liuyiwei1317629/esp32/bridge/screen_assets/offline_320x240.jpg

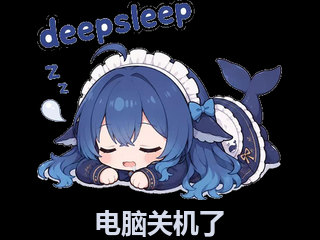
bridge/screen_assets/offline_320x240.jpg
