liuyiwei1317629/esp32/HANDOVER-G.md

# G 包交接单（ESP32-S3 硬件上机 / 录音回放）

> 用途：新对话接手的唯一上下文来源。只写结论与依据，不复述对话过程。
> 更新时间：2026-10-26 21:47
> 21:47 **定稿**：沙沙、响度一致性、破音三项全部收口。最终版 `snapshots/2026-10-26_final-v3/`（`TARGET_RMS=2700` / `GAIN_MAX=8.0`）。
> 本次更正两条大错：① 烧录口**不是 CDC，是 CH343**（对应板上 COM 口），旧记录「与 CDC 口同一路」作废；
> ② `compThr` 阈值参照系 bug 已修 —— 这才是历史上「增益乱跳」的真身，与地、与硬件都无关。
>
> **2026-10-27 补记（联网部分已过，本文其余内容仍有效）**：
> - 联网两模式已上机：TURN 多轮 `result=ok`（`first_pcm_ms` 2.2–4.2 s），TURN_STOP 播放中按 BOOT 打断 `stop_ms=20/18`、`result=aborted`。当前烧的是 `APP_MODE_TURN_STOP`。
> - 开机 6 声诊断音阶**已删除**（只留录音开始那声 60 ms「嘀」）：带音阶时 4 次录音全零，删掉后每次 `voice=1`——经验事实，机制未查清，不要写成结论。
> - 播放缓冲 1 s → 3 s（`PLAY_STREAM_BYTES_MAX=98304`，不够时自动降 2 s / 1 s）。长回复断续从中后段大面积补静音缩到只在开头约 1 秒；开口缺口已定位为 bridge 侧 TTS 启动生产赤字（2026-10-27），**不归硬件管**，固件无需再改。
> - 录音/放音的电气参数（`CLIP_TARGET_RMS=2700`、`CLIP_GAIN_MAX=8.0`、音量天花板 8000）**全部不变**。

---

## 0. 一句话现状

**录放链路已定稿可用**：沙沙解决、响度一致、无破音。最终参数 `CLIP_TARGET_RMS=2700` / `CLIP_GAIN_MAX=8.0`，
快照 `firmware/voice_terminal/snapshots/2026-10-26_final-v3/`。

| 交付要求 | 状态 | 关键事实 |
|---|---|---|
| 回放无沙沙 / 无毛刺 | ✅ 已解决 | 地路径长度是**唯一**主因。模块与板子同坞 + 板子换 25 cm 短线即干净（3.11、3.12-A） |
| 响度一致 | ✅ 已解决 | 根因是 `compThr` 参照系 bug，2026-10-26 21:15 已修（3.13） |
| 音量够 | ⚠️ **触到硬件天花板** | 功放数字峰值上限约 **8000**，超过即模拟削顶（破音）。想更响只能换 4Ω 喇叭或提高功放供电 |

**这条硬件的音量天花板已经摸到**：`play_peak ≈ 6600` 不是调出来的，是 MAX98357A（12 dB 增益）在 5 V 下的输出能力决定的。
再往上抬只会破音（4500 版 12745 实测「每个字开头结尾带咔」），**不要重复走这条路**。

**下一步不在音频**：音频收尾，进入联网部分（`APP_MODE != RECORD_ONLY`）。

---

## 1. 现在要做什么 / 最后交什么

**当前任务**：让 `C:\Users\DELL\voice-ai\firmware\voice_terminal` 在 ESP32-S3（ICS43434 数字麦 + MAX98357A 功放模块 + 小喇叭）上实现「按住说话 → 松手本地回放」，且回放**干净无毛刺、音量稳定、音量够用**。

**最终交付**：
1. 固化好的 `config.h` 参数集（不再逐次试错，能直接用的稳定版）
2. 一份硬件接线 + 烧录说明（含 bootloader patch 步骤，换 core 版本要重打）
3. 之后才进入联网部分（`APP_MODE != RECORD_ONLY` 的 Wi-Fi / HTTP 链路）

**当前工作模式**：2026-10-26 定稿时为 `APP_MODE_RECORD_ONLY`；2026-10-27 起改烧 `APP_MODE_TURN_STOP`（联网 + 打断），`MIC_DUMP = 0`（base64 导出已关）。

---

## 1.1 里程碑：录放链路定稿（2026-10-26 21:47）

三项硬要求全部收口。**当前 `final-v3` 是可交付版本**，可以直接进联网部分。

| 快照 | 参数 | 状态 |
|---|---|---|
| `snapshots/2026-10-26_clean-v1/` | `TARGET_RMS=1400` | 历史版，音质干净但音量偏小 |
| `snapshots/2026-10-26_clipfix-v2/` | `TARGET_RMS=4500` / `GAIN_MAX=12` | **有破音，勿用**（play_peak 12745 超过功放上限） |
| `snapshots/2026-10-26_final-v3/` | **`TARGET_RMS=2700` / `GAIN_MAX=8.0`** | ✅ **当前定稿** |

定稿实测（连录 5 次，其中 2 次因音量太小被固件主动丢弃）：
`play_peak = 4772 / 6170 / 6631`，`gmax = 6.05~6.46×`，最高只到功放上限的 83%。

**接法定稿（双线并行，已实测无沙沙）**：

| 线 | 插哪个口 | 承担 |
|---|---|---|
| 长线（有数据芯） | 板子的 **COM 口** | CH343 → COM5，烧录与日志 |
| 25 cm 短线（纯供电） | 板子的 **USB 口** | 承担音频回流，地路径短 |

两根线插同一个坞。**好处是不用为调试反复拔线**——之前"短线干净但没数据、长线有数据但地长"的死结由此解开。
（原理：两个口的 5V/GND 在板内是同一组铜箔，音频回流优先走阻抗更低的短线。）

---

## 2. 最新要求 / 已作废的旧要求

### 2.1 仍然有效的要求

| 要求 | 来源 | 当前状态（2026-10-26 21:47） |
|---|---|---|
| 回放不能有任何毛刺、发毛、沙沙声 | 用户连续 5 轮明确反馈 | ✅ **已达成**。地路径是唯一主因（3.11 / 3.12-A） |
| 同样距离、同样音量说话，几次回放响度要一致 | 用户：「前两次有可能一样，后两次可能不一样」 | ✅ **已达成**。根因是 `compThr` 参照系 bug（3.13），修复后波动 5.2 倍 → 1.06 倍 |
| 音量要够（能听清、不费劲），但不能用失真换 | 用户：15000 时「大小正好」但同时「毛刺」 | ⚠️ **部分达成**。不破音优先，实际音量受功放 8000 削顶约束（3.14）。注意：用户当年说「15000 正好」时同时有毛刺，那个判断本身可能不可靠 |
| 用户不会用万用表、不会拆 2P 母头，所有指导必须"插上/接上就行" | 用户明确表示 | 持续遵守 |
| 每次改动后必须让用户实测并回报三个数：`mic_raw` / `clip` / `play_peak` | 本包工作方式 | 持续遵守 |

### 2.2 已作废的要求（不要再按这些方向做）

| 作废内容 | 作废原因 |
|---|---|
| 「把回放峰值推到 15000 / 21334 换取音量」 | 实测该电平必然毛刺/破音，是削顶 |
| 「播放侧做逐块 AGC（最高 8×）补音量」 | 与录音侧归一化叠加两次，底噪被抬到满幅 |
| 「归一化基准用块峰值的 95 分位」 | 短句时 95% 的块是静音，估算失真（gain 掉到 0.57×）|
| 「降噪门压深到 0.22（-13 dB）」 | 产生音节级抖动；且后来证实不是毛刺主因 |
| 「存在感提升 +5 dB」→ 现为 +2 dB | +5 明显偏冲、刺耳 |
| 「I2S TX 用 MONO 槽位」 | MAX98357A 只认 32/48/64 BCLK-per-frame，单槽输出噪音 |
| 「用 `psramFound()` 判 PSRAM」 | Arduino 的 `spiramFailed` 标志会误报，必须用 `esp_psram_get_size()` |
| 「固定 6× 数字增益」 | 满幅方波触发功放过流保护 → 彻底静音 |

---

## 3. 已确认的事实（每条附依据）

### 3.1 硬件与工具链

| 事实 | 依据 |
|---|---|
| SoC：ESP32-S3 N16R8（16MB flash / 8MB OPI PSRAM） | esptool `flash_id` + `esp_psram_get_size()` 实测 |
| Flash 是 XMC，JEDEC `0x207018`，**不在 IDF 白名单内** | `bootloader_flash_xmc_startup` 反汇编 |
| 必须 patch 4 个 bootloader ELF，偏移 `0x3EF1`，`66caed` → `661aed`（`bnei a10,32` → `bnei a10,1`） | 已 patch 并验证可启动；**升级 esp32 core 后需重打**，原件备份在 `D:/arduino-cli/bootloader-backup/` |
| `FlashMode` 必须 `dio`（QIO 启动失败） | 编译/启动实测 |
| 烧录口 = **COM5 = CH343**（`USB\VID_1A86&PID_55D3`），对应板上的 **COM 口**；**不是 native CDC** | 2026-10-26 21:23 `Win32_PnPEntity` 实测设备名 `USB-Enhanced-SERIAL CH343 (COM5)` |
| 板上共两个 Type-C 口：**COM**（经 CH343 → UART0/GPIO43-44）与 **USB**（直连 SoC 原生 USB，GPIO19-20）。**两口的 5V/GND 在板内是同一组铜箔** | 同上实测 + 板面丝印（ESP32-S3 2025-V1.4） |
| ⚠️ 旧记录「烧录口与 CDC 口是同一路」**是错的**（2026-10-26 21:23 更正）。22:00 前查 VID_1A86 得 0，是因为当时插的是无数据线芯的纯充电线，CH343 未被枚举——**不是板子没有桥** | 两条记录对照 |
| 串口监视必须 `DtrEnable=false`，并手动拉 `RtsEnable` 触发复位；`arduino-cli monitor` 不会触发复位 | 反复试出来的 |

### 3.2 接线（用户提供的引脚分配，已按此跑通有声）

```
话筒 ICS43434 :  BCLK=GPIO4   WS/LRC=GPIO5   SD/DATA=GPIO6
功放 MAX98357A:  BCLK=GPIO15  WS/LRC=GPIO16  DIN=GPIO7
```

> ⚠️ **2026-10-26 15:01 更正（重要）**：此前这里写的「模块针序 VCC GND LRCLK BCLK DIN WS SCK SD」
> **是未经验证的推断，已作废**。用户明确说明：**模块只有一个 GND，没有可插杜邦线的 VCC / GND 针**。
> 模块供电只有那根**一体注塑、掰不开的自带 USB 线**（红=5V、黑=GND）。
> 也就是说：**「给模块 GND 针补一根杜邦线到板子 GND」这一步在物理上做不到**，不要再去指导用户这么做。
> 同理，别假设模块有可用焊盘或第二个接地点——这一点**仍未确认**，需要用户拍模块正反面照片才能定。

- 模块内部**没有共同时钟**（测过 7 组引脚，全 open）
- 喇叭未损坏（`tx_only_check` 探针能出声）
- **共地方式（重要，勿搞错）**：模块 GND 与板子 GND 之间**没有、且在现有硬件上也加不了直连线**。共地只能"借道"：
  ```
  模块 GND ─黑线→ 电脑 USB 口A 的 GND ─主板→ 电脑 USB 口B 的 GND → 板子 GND
  ```
  因此**两个 USB 口必须来自同一台电脑**，否则 I2S 失去公共参考（表现是噪音或无声）。
  > 这条「借道主板」的地不是等效的好地：功放的开关电流（几百 kHz、峰值可到 0.5 A）也走这一段，
  > 于是地电位随输出电流上下晃 —— 这与 3.9「噪声跟着输出电流走」的结论方向一致。
  > **现有硬件无法改善这条地**，能做的只有降电平或换模块（见 7）。

### 3.3 录音链路（已验证正常，不要再怀疑）

- 实测一次正常录音：语音从 448 ms 开始，频谱 **500–1000 Hz 占 49.6%**、250–500 Hz 占 25%
- 话筒原始峰值 `s16` 约 2600–4500（满幅 8%–14%），RMS 470–820
- `underruns=0`，`play_ms` 与 `record_ms` 基本一致
- 结论：**话筒、I2S RX、编码、增益链路全部正常**

### 3.4 用户声音的频段特征（决定了滤波器设计）

对导出的原始 PCM 做 FFT：

```
0-250 Hz  47.90%
250-500   44.67%
500-1000   2.26%
1000-2000  1.46%
最强峰：207 / 208 / 230-232 Hz
```

即 **92% 能量在 500 Hz 以下，最强峰在 210 Hz 附近**。小喇叭在这段需要最大电流和行程，是最容易失真的频段。

### 3.5 播放链路的关键约束（都是实测踩出来的）

| 约束 | 依据 |
|---|---|
| I2S TX 必须 **STEREO** 槽位（32 BCLK/frame），数据左右两槽写同一份 | 单槽（16 BCLK/frame）时功放输出纯噪音 |
| 播放期间必须 **`rxDisable()`**，播完再 `rxEnable()` | 两路 I2S 争用同源时钟，RX 开着时功放完全收不到有效帧（静音） |
| DMA：`TX_DMA_DESC=6` × `TX_DMA_FRAME=240` = 1440 帧 ≈ 90 ms 缓冲 | 当前配置，`underruns` 一直为 0 |
| 播放任务 `audio_tx` 优先级 4、钉在 core 1，高于 Arduino `loop` | 不会被串口打印抢占 |

### 3.6 电平阶梯实测（关键，但只有两个点可信）

用固件内置的 1 kHz 纯音阶梯（**不经话筒、不经任何滤波**）：

| 报告 | 结论 |
|---|---|
| 「第 3~4 声之后 1234567 就全都是噪音了」（4000→16000 七级） | 8000 起明显噪音 |
| 「第二声。有毛刺儿」（5000/6000/7000/7800 版，第二声 = 6000） | **6000 已有毛刺** |
| 4000 干净 | 干净区上界 ≥ 4000 |

**注意**：因为纯音也不干净，所以毛刺**不在录音链路、也不在数字滤波/压缩算法里**，一定在 I2S TX 之后（功放 / 供电 / 喇叭）。

> ⚠️ 本节的「8000 是上限」「6000 已有毛刺」**已被 3.9 修正**：那两轮测试时软限幅器的拐点分别是 7000 和 4200，用户听到的"噪音"大部分是限幅器削波，不是功放。真实上限远高于 8000。

### 3.9 决定性实验：噪声跟着输出电流走，不跟数据跳变走（2026-10-26，已确诊）

前面所有测试都混着两个变量，这一轮用 2 的幂做 2×2 对照 —— 2 的幂二进制只有一个 1，
所以无论幅度多大，DIN 每帧只跳变 1 次，可以把「输出电流」和「数据跳变」彻底分开：

| 段 | 直流值 | DIN 每帧跳变 | 输出幅度 | 用户听感 |
|---|---|---|---|---|
| F1 | 2048 (`0x0800`) | **1 次** | 6.25% | 有沙沙 |
| F2 | 8192 (`0x2000`) | **1 次** | 25%（电流 ×4） | **明显更吵** |
| F3 | 2000 (`0x07D0`) | **5 次** | 6.1%（跳变 ×5） | 不比 F1 吵 |
| F4 | 0 | 0 次 | 0 | 基线，很微小 |

**结论（这是目前最硬的一条）：**

- **F2 > F1** → 跳变次数相同、电流差 4 倍 → 噪声随**输出电流**上升
- **F3 ≈ F1** → 幅度几乎相同、跳变差 5 倍 → 噪声**与数据跳变无关**

所以噪声是**加性、随输出功率增长**的电源侧噪声（去耦不足或供电电流不足），
不是位误读、不是串扰、不是时钟抖动、不是数据传输出错。

同一轮的另外三条支持证据：

- 恒定直流（DIN 无跳变）**也有**沙沙 → 排除"数据传输错误"
- 采样率 16 kHz → 8 kHz（BCLK 512 kHz → 256 kHz）**一样脏** → 排除信号完整性与时钟相关问题
- 同配置连测两次结果**一致** → 排除接触不良这类随机故障

### 3.7 提示音尾音污染归一化（已修复）

每次录音的前 1–2 个 32 ms 块 RMS 高达 2018–2120，随后骤降到 200 左右 —— 那是按键提示音「嘀」的尾音被话筒拾取。
后果：归一化把尾音当最大峰值，5 次录音的增益在 **3.72× ~ 7.48×** 之间乱跳，表现为"有时响有时轻"。

已修：录音丢开头 5 帧（100 ms）+ 峰值统计跳过前 3 块 + 提示音电平降到 4000/60 ms + 回放开头 64 ms 淡入。

### 3.8 用户当前供电方式（拓扑已确认）

**历史拓扑（前三轮全部测试都是这个）——两个 USB 口都来自同一台电脑**：

- 板子：USB 线接电脑（同时提供 COM5 串口）
- 功放模块：**另一根独立 USB 线**（红=5V、黑=GND，外壳一体注塑、掰不开、不能拆）接电脑的另一个 USB 口

因此模块与板子之间**没有 GND 杜邦线**，共地靠电脑主板"借道"（详见 3.2）。

**拓扑至今未变（2026-10-26 14:12 用户明确确认）**：用户原话「没有用，供电都是电脑供的」。
所有测试（包括我让你试充电头的那几轮）实际都是**板子插一个 USB 口、模块插另一个 USB 口，两路都来自同一台电脑**。
两个充电头只是备选，**从未真正接到模块上跑过测试**。

> 「USB 口 500 mA 限流是瓶颈」：**未实测排除**，但推理上不成立 —— 见 4 节候选 B。

### 3.10 独立电源方案（**未执行** —— 用户已明确：供电都是电脑供的）

用户手上有两只 USB 充电头，但**都没有接入测试过**。参数记录如下，供真正执行这一步时用：

| 电源 | 参数 | 状态 |
|---|---|---|
| 亚力通 P168S（2016） | 输入 110–240V 200mA，输出 **5.0V ⎓ 1A Max** | 未使用 |
| J-120W 开关电源适配器 | 输入 220V 50Hz 0.8A，输出 **5V3A / 9V2A / 11V1.5A / 12V1.5A**（多档快充） | 未使用 |

> 若将来确实要用：模块自带那根 USB 线的外端直接插 `P168S` 的 USB-A 口即可（红=5V、黑=GND），
> 但**必须同时补一根杜邦线把模块 GND 接到板子 GND**，否则 I2S 回流绕经市电，只会更脏。
> 右侧那只多档快充头不要长期用——一旦握手异常升压到 9V/12V 会直接烧 MAX98357A。

> ⚠️ **2026-10-26 14:12 更正**：本节曾写成「已换两个充电头、结果一样脏，据此作废候选 B」。
> **该实验并未发生**，用户原话是「没有用，供电都是电脑供的」。该结论已撤回，候选 B 恢复为"低可信度、未实测排除"。

---

### 3.11 集线器（hub）对照：地回路坐实为主因（2026-10-26 20:40）

**唯一变量**：模块的 USB 线从「插电脑另一个 USB 口」改成「插同一个 USB 集线器」，板子也插在这个集线器上。
固件未改、`config.h` 未改，靠 `setup()` 里自带的 6 声阶梯判读
（800/900/1000/1100/1200/1300 Hz，电平 4000/6000/8000/12000/16000/20000，每次按 RST 自动跑一遍）。

| | 干净区上界 | 6000 那一级 | 用户用词 |
|---|---|---|---|
| 插坞前（历史记录） | **< 4000**（连 4000 也脏） | 有毛刺 | 「都有杂音」 |
| 插坞后 | **≥ 4000**（第 1 声干净） | 微弱沙沙 | 「明显变轻了」 |

**判读**：只缩短了地路径，没加任何电容、没改电流，噪声就下降一整档 → **候选 C（共地只能借道电脑主板）是主因**。

连带推论（三条都会影响选型，别再按旧结论走）：

- **候选 A（模块 VCC 去耦不足）不是主因**。插坞没有增加任何去耦，噪声依然大幅下降。7 针模块降级为"可选"，不是必须。
- **候选 B（供电电流不足）可以划掉了**。集线器上是多个口共享一个 USB 口（约 500 mA），比原来更紧，噪声反而更轻。
- **路 A（继续压低电平）作废**。当前 `CLIP_PEAK_CAP=4600` 正好落在插坞后的干净区内，不要再往下压。

**但地路径仍然不短**，当前这条回路是：
```
模块 GND ─30cm USB 线→ 坞 PCB ─板子那根 USB 线→ 板子 GND
```
板子那根 USB 线如果是 1 m，地还是长的。所以下一步不是换模块，是继续缩短这条路径（见 7 路 C）。

---

### 3.12 地问题已闭环 + 两个新发现（2026-10-26 21:00）

**A. 地回路彻底解决**

- 操作：模块与板子**同插一个 USB 集线器** + 板子换 **25 cm 短线**（USB-A → USB-C）
- 结果：用户原话「**没有沙沙声了**」——阶梯 6 声全部干净
- 结论：**地路径长度是唯一主因**，3.11 坐实。路 C 的 C-1 已完成，**C-2（USB 母座转端子）已无必要**，不必再买。

**B. ⚠️ `CLIP_PEAK_CAP` 是死参数（重要，会影响以后所有调参结论）**

- 全仓库只有 `audio_io.cpp:300` 那一行 `Serial.printf("... cap=%d", CLIP_PEAK_CAP)` 读它，**没有任何一处用它限制峰值**
- 真正的上限只来自 `softLimit()`（`LIMIT_KNEE`/`LIMIT_ROOM` = 32000/1，等于不限制）+ 32767 硬钳位
- 所以历史上若干轮「调峰值上限」改的都是这个死值，**「改了没变化」是正常现象，不是用户听错**
- **音量唯一真正的旋钮是 `CLIP_TARGET_RMS`**（块增益 = TARGET_RMS / 块RMS，上限 `CLIP_GAIN_MAX`=8×）

**C. 那根 25 cm 短线是纯充电线，没有数据线芯**

- 证据：`Win32_PnPEntity` 里查不到任何 USB 串口芯片（VID_303A / 1A86 / 10C4 / 0403 全部为 0），
  `COM3` / `COM4` 是蓝牙虚拟串口，`COM5` 已消失
- 表现：板子上电、能跑阶梯、能出声，**但串口不见，无法烧录**
- 处理：**烧录时换回有数据的线，烧完立刻换回短线听**（长线会让沙沙回来，但不影响烧录）
- 这根充电线以后接电池方案时正好用（电池场景只需供电，不需要数据）

---

### 3.13 `compThr` 阈值参照系 bug —— "增益乱跳"的真身（2026-10-26 21:15 修复）

**症状**：同一句话连录，回放响度忽大忽小。用户描述"前两次一样、后两次不一样"，
历史记录里出现过增益在 3.72×~7.48× 之间乱跳。**此前一直误判为地噪声的副作用，实际与硬件无关。**

**实测数据（修复前，连录 8 次，同一句话同一距离）**：

| 输入 RMS | 输入峰值 | play_peak | 实际倍数 |
|---|---|---|---|
| 493 | 1540 | 6202 | 4.0× |
| 515 | 1415 | 4396 | 3.1× |
| 506 | 1187 | 3867 | 3.3× |
| 497 | 1332 | 3990 | 3.0× |
| 547 | 1218 | 2154 | 1.8× |
| 505 | 1534 | 4865 | 3.2× |
| 502 | **1196** | **1196** | **1.0×** |
| 476 | 1298 | 3737 | 2.9× |

最后那行是铁证：`play_peak` 与输入 `peak` 一个 LSB 不差，压缩**完全没有启动**。

**根因**（`audio_io.cpp` 第 5a 步，修复前）：

```cpp
const float compThr = floor_rms * CLIP_COMP_THR;  // floor_rms 来自【滤波前】块 RMS 的 20 分位
float r = postRms[k];                             // postRms 是【滤波+门控后】的能量
```

`postRms` 经过两级 4 阶高通（250 / 300 Hz，正好砍在语音主能量上）再乘门控 0.70，
实际只剩滤波前的 1/3~1/4。用滤波前的底噪 ×2.5 去卡滤波后的能量，**门槛虚高约 10 dB**，
大量真实语音块被判为静音 → `want=1.0` → 整段不压缩。

于是增益在「1.0×（全段不压）」和「4×（块块过线）」之间二值跳变，取决于那一刻说话多响。
这也解释了为什么"凑近说反而更弱"——输入变轻，整段掉进不压缩区。

**修法**：底噪改用 `postRms` 自己的 20 分位（`floor_post`），与被比较量同尺度；
日志探针从 `g0/gN`（首末块，恒为 1.00×，毫无信息量）改为 `floor=滤波前/滤波后`、`thr`、`g=min~max`。

**修复后实测（`TARGET_RMS=3000`，连录 3 次）**：`play_peak = 7452 / 7659 / 7879`，
**波动从 5.2 倍降到 1.06 倍**；输入 RMS 533/558/581 本身差 9%，输出比输入还稳。

**教训**：`g0/gN` 这种"首末块"探针会伪装成"没压缩"。排查压缩问题必须看**全段最大增益**。

---

### 3.14 功放削顶上限约 8000（2026-10-26 21:34 实测坐实）

`CLIP_TARGET_RMS=4500`（`GAIN_MAX=12`）时实测 `play_peak=12745`，用户听到「每个字开头结尾带咔/破音」。
退到 3000（`GAIN_MAX=8`）后连录 4 次 `play_peak = 8618 / 6485 / 7853 / 7221`，
用户确认「8618 那次破音、其余三次正常」——**上界坐实在 8000 附近**。

- 削波发生在 **MAX98357A 的模拟侧**（12 dB 增益把数字满幅推到电源轨），不是数字侧
  （12745 远低于 32767，也远低于 `softLimit` 拐点 32000）
- 数字侧完全干净，**不要试图靠调 `CLIP_PEAK_CAP`（死参数）解决**
- **不要调低 `LIMIT_KNEE`**：软限幅是逐样本非线性压缩，会引入谐波（听感"糊"），
  为偶发峰值牺牲整体音质不划算。正解是压低整体目标，让峰值天然落进安全区
- 想真正更响：换 **4Ω 3W 喇叭**（同一电压下比 8Ω 响约一倍），或提高功放供电。
  两者都属硬件改动，且会改变声学负载，噪声与破音需重测

---

## 4. 未验证的推测（不可当事实用）

| 推测 | 可信度 | 如何验证 |
|---|---|---|
| 噪声来自**电源侧**（3.9 已确诊：随输出电流上升，与数据跳变、时钟频率无关）。细分到哪一环，尚未区分 | 方向：已确诊；细分：未知 | 见下三行 |
| └ 候选 A：模块 **VCC 去耦不足**（成品模块电源脚只有一颗 10 µF，缺 100 µF 电解 + 0.1 µF 陶瓷） | **高**（3.10 排除候选 B 后升为首选） | 在模块 VCC–GND 之间就近并 100 µF 电解 + 0.1 µF 陶瓷，噪声明显下降即证实 |
| └ 候选 B：**供电电流不足**（电脑 USB 口约 500 mA，功放峰值需 1 A 以上） | **低**：未实测排除，但 F1 段只有 6.25% 电平（DC 2048）、电流仅几十 mA 就已"有沙沙"，任何 USB 口都供得起 | 接 3A 独立电源实测才能排除，做法见 3.10 |
| └ 候选 C：**共地只能借道电脑主板**——模块唯一的地是 USB 线黑线，没有可插杜邦的 GND 针 | **高**，但**现有硬件无法验证也无法修复** | 只能换带 VCC/GND 杜邦针的 7 针模块（见 7 路 B） |
| 小喇叭机械擦圈 / BTL 输出在大量程下非线性（也能解释"随电流变脏"） | 低（静音时基线很微小，说明功放静态干净） | 换一只喇叭对比；或同电平下换频率看脏度是否随行程变化 |
| MAX98357A 实际增益 ≈ 4.1×（12 dB），不是模块常说的 9 dB | 中（由"8000 开始削顶"反推，32767/8000≈4.1） | 查模块 GAIN/SD 脚电阻分压配置，或用示波器看输出摆幅 |
| 喇叭阻抗是 8Ω | 低（**完全未确认**） | 看喇叭背面丝印，或量直流电阻（用户无万用表，暂不可行） |

---

## 5. 试过不行的路（别重复）

| 试法 | 结果 | 原因 |
|---|---|---|
| 固定数字增益 6× | 播到 `play_peak=32768` 后**彻底静音** | 满幅方波触发功放过流保护 |
| 播放侧逐块 AGC（最高 8×） | 「能听清但有巨大噪音」 | 与录音侧归一化叠加两次，底噪被抬到接近满幅 |
| 归一到 21334 | 「破音」 | 远超安全电平 |
| 归一到 15000 + 95 分位基准 | 「毛刺」+ 增益 0.57× 自我衰减 | 分位数估算错误 + 电平过高 |
| 降噪门 0.22 / −13 dB | 「毛刺」 | 音节级增益抖动；但门改浅后毛刺仍在，**证明不是主因** |
| 存在感 +5 dB | 「刺」 | 过冲 |
| 把峰值一路推到 16000 换响度 | 「全都是噪音」 | 方向本身错了，音量不能靠抬峰值 |
| 每次录音前 base64 导出 PCM（18 秒） | 用户以为设备卡死 | 应改用其他方式取证 |
| 换采样率 16k→8k（BCLK 512k→256k）、电平逐级 4000→20000 | 一样脏 | 见 3.9：与时钟频率、数据跳变无关 |

---

## 6. 冲突与待澄清（不要自行取一个当事实）

1. **B 声（16000）到底干不干净**：用户先说「听到嘀了，回放也有声」「干净」，后说「B 也有呃，杂音」。→ 按后者（有杂音）处理。
2. **噪声起始电平**：先说「3~4 声之后全噪音」（→8000），后说「第二声有毛刺」（→6000）。→ 取更严格的 6000。
3. **安全上限数值**：早期文档推算 11600（按 9 dB 增益），与实测「8000 就削顶」冲突。→ **以实测为准**，11600 作废。
4. **"15000 时声音大小正好"**：该次同时有毛刺。→ 不能作为目标音量，只能说明用户期望的响度参考值在"听起来有 15000 那么响"的量级。
5. **毛刺是否与频率有关**：用户报告扫频「有断续/杂音」，但没说清在低频还是高频段。→ 未定，不要假设。

### 6.1 我（上一轮 agent）编造过、已被用户当场否掉的硬件事实

**下一个对话接手时，下面这些一律不许当成已知条件：**

| 我编的说法 | 实际（用户指出） |
|---|---|
| 「模块 GND 要接板子 GND」这一步 | 用户：「没有供地线。你这里不对」 |
| 「SD 引脚就是功放 GAIN 脚」 | 混淆了话筒 ICS43434 的 SD 与 MAX98357A 的 SD_MODE，整条推论作废 |
| 「模块针序 VCC GND LRCLK BCLK DIN WS SCK SD」 | 用户：「一个一个，只有一个 GND」——**模块没有可插杜邦的 VCC/GND 针** |
| 「已换两个充电头供电、结果一样脏」 | 用户：「没有用，供电都是电脑供的」——该实验从未发生 |

**结论**：凡是涉及「模块上有什么针 / 焊盘 / 接地点」的陈述，**在拿到模块照片前一律不许写**。
现在唯一确定的物理事实只有：模块自带一根一体注塑的 USB 线（红=5V、黑=GND），只有一个 GND。

---

## 7. 下一步 + 合格标准

> ⚠️ 「加一根 GND 杜邦线」这条**已作废**（2026-10-26 15:01）：模块只有一个 GND，且是 USB 线里的黑线，
> 没有可插杜邦的 GND 针。这一步物理上做不到。下面两条是现在真正可走的路。

### 路 C（当前主路，免费 + ¥3）：继续缩短地路径

依据：3.11 已证明缩短地路径有效，且效果显著。所以继续压这条路径，而不是换模块。

**C-1（免费，今天就能做）**：把**板子那根 USB 线换成最短的**（30 cm 级）。
现在的地回路是「模块 30cm 线 → 坞 → 板子那根 USB 线 → 板子」，板子那根线如果是 1 m，地就是长的。
换完再按一次 RST，听第 2 声（6000）的沙沙有没有退掉。

**C-2（¥3）**：买 **USB 母座转接线端子**（搜「USB母座转接线端子」「USB母头转接板 端子」）。
模块自带的 USB 线插进母口，端子上的 +5V / GND 用两根杜邦线接到板子的 5V 针和 GND 针。
- 不用焊、不用剪线、不用万用表，拧螺丝就行
- 效果：模块彻底脱离电脑，地路径从「30cm + 坞 + 板子的线」缩到「30cm + 5cm」
- 注意：模块的电流从此走板子的 USB 口（500 mA 上限）。如果板子反复重启 = 电流顶到了，退回集线器方案。

**合格标准**：阶梯第 2 声（6000）的沙沙消失，或真实录音回放（当前 `CLIP_PEAK_CAP=4600`，已落在干净区内）听着干净。

**C 路失败再考虑路 B**：如果地路径压到最短、真实录音回放仍脏，剩下的才是模块去耦（候选 A），那时才买 7 针模块。

### 路 A（❌ 已作废，2026-10-26 20:40）：把电平再压低

> 作废原因：3.11 证明噪声主要不是电平问题，而是地路径问题。且当前 `CLIP_PEAK_CAP=4600`
> 已落在插坞后的干净区内，再往下压只是白丢音量。**不要再调这两个参数。**
> 以下内容仅存档，不要执行。

**注意**：最新一轮 6 档阶梯（4000 / 6000 / 8000 / 12000 / 16000 / 20000）用户报的是「都有杂音」——
**连 4000 也脏**，所以"4000 是干净区"这个旧结论在当前配置（限幅器已旁路）下**不成立**，不要再引用。

仍然值得一试的理由：沙沙的响度确实跟着电平走（3.9 已证），往下压到 2000~3000 时沙沙会退到"底噪级"，至少不刺耳。

- 操作：`CLIP_PEAK_CAP` 4600 → **3000**，`CLIP_TARGET_RMS` 1400 → **900**，编译烧录，录 3 次话
- 合格标准：3 次回放里沙沙**不刺耳、不盖住人声**（不要求完全消失）
- 若不通过 → 路 A 这条也不成立，只能走路 B
- 代价：明显小声。这是拿音量换安静的临时方案

### 路 B（根治，需要买一块模块）：换标准 7 针 MAX98357A 模块

现在这块是**自带 USB 线的成品音箱板**：供电只能走 USB，没有 VCC/GND 杜邦针，
所以永远只能"借道电脑主板"共地 —— 这个拓扑下的地噪声**没法修**，也不排除模块本身去耦就不够。

- 要买的是：**7 针杜邦排针的 MAX98357A 模块**（VIN / GND / LRC / BCLK / DIN / GAIN / SD），
  电源脚最好带 **≥100 µF 电解 + 0.1 µF 陶瓷**去耦
- 换上去之后才第一次真正做到「模块 GND ── 短线 ── 板子 GND」的共地，同时也解决了 VCC 去耦
- 到货后用 3.9 的 2×2 对照复测：F1 / F2 的脏度差应该消失
- 合格标准：2×2 里 F2 不比 F1 明显更吵；录音回放在 12000 以上还能听清

### 建议顺序

**路 C 是主路**（2026-10-26 20:40 改）：地回路已被 3.11 证明是主因，所以按"继续缩短地路径"走——C-1 免费、C-2 只花 ¥3，都比等快递快。
**路 B 降级为备选**：只有当 C 路压到最短、真实录音回放仍然脏时，才说明模块去耦不足，那时再买 7 针模块。
**路 A 作废**：别在电平参数上反复调（历史上已经为它调了 10+ 轮）。

### 唯一待用户确认的硬件信息

**模块正反面照片**。现有描述里「模块有 VCC/GND 杜邦针」是我推断出来的，用户已指出不成立；
在拿到照片前，**不要再对模块引脚做任何假设**（不要再说"接 GND 针 / VCC 针 / 焊盘"）。

---

## 8. 操作速查（接手直接用）

**源码目录**：`C:\Users\DELL\voice-ai\firmware\voice_terminal\`
（`voice_terminal.ino` / `audio_io.cpp` / `audio_io.h` / `config.h`）

**编译**
```
cd C:/Users/DELL/voice-ai/firmware && \
D:/arduino-cli/arduino-cli.exe --config-file D:/arduino-cli/arduino-cli.yaml compile \
  --fqbn "esp32:esp32:esp32s3:FlashMode=dio,FlashSize=16M,PSRAM=opi,PartitionScheme=default,CDCOnBoot=default" \
  --output-dir D:/arduino-build/g-record voice_terminal
```

**烧录**
```
同上，把 compile 换成：upload -p COM5 --input-dir D:/arduino-build/g-record
```

**串口抓取**（PowerShell，必须 `DtrEnable=$false`，否则不复位）
```powershell
$sp = New-Object System.IO.Ports.SerialPort("COM5",115200,"None",8,"One")
$sp.DtrEnable = $false; $sp.RtsEnable = $false; $sp.Open()
# 循环读 BytesToRead 写文件；抓取期间串口被占用，烧录前必须先停掉
```
日志落在 `C:\Users\DELL\WorkBuddy\2026-10-26-06-53-55\.tmp\serial_captureNN.txt`

**抓取与烧录互斥**：串口被占用时 `upload` 会报 `Could not open COM5`，必须先停抓取进程。

**当前关键参数（config.h）**

| 参数 | 值 | 含义 |
|---|---|---|
| `CLIP_TARGET_RMS` | **2700**（2026-10-26 21:42 定稿） | **音量唯一真正的旋钮**：块增益 = 本值 / 块RMS。上限受功放 8000 削顶约束（3.14） |
| `CLIP_GAIN_MAX` | **8.0**（2026-10-26 定稿） | 块增益上限。曾设 12，导致 gmax 到 9.4×、峰值 12745 破音，已回退 |
| `CLIP_PEAK_CAP` | 4600 | ⚠️ **死参数，不生效**，只被串口日志打印。调它没有任何作用，见 3.12-B |
| `LIMIT_KNEE` / `LIMIT_ROOM` | **32000 / 1** | 软限幅**已旁路**（拐点抬到顶、压缩区间压到 1），只做防溢出钳位——毛刺主因曾是这个限幅器 |
| `PLAY_FIXED_GAIN_Q8` | 256 | 播放侧固定增益 1.0×（不再做二次放大） |
| `CLIP_HP_HZ` / `CLIP_HP2_HZ` | 250 / 300 | 两级高通（4 阶，砍 200–300 Hz） |
| `CLIP_LP_HZ` | 3800 | 低通 |
| `CLIP_PRESENCE_DB` | +2.0 @ 2.2 kHz | 存在感提升 |
| `CLIP_GATE_FLOOR` | 0.70 | 静音块只压 −3 dB |
| `CLIP_COMP_THR` | 2.5× **滤波后**底噪 | 低于此的块不参与压缩。**注意：参照系必须是 `postRms` 自己的分位**，用滤波前的 `floor_rms` 会虚高 10 dB（3.13 的 bug）|
| `CLIP_MIN_PEAK` | 500 | 滤波后峰值低于此则整段丢弃不播。**说话太轻/太远会完全没声音**，当前已知副作用 |

**信号处理顺序**（`clipEnhance()`，全部在录音完成后一次性做）
```
去直流 → 高通250 → 高通300 → 峰值EQ 2.2k → 低通3800
→ 块RMS(32ms) → 底噪取20分位 → 浅门控(±2块平滑)
→ 块级压缩(快攻慢放+双边平滑) → 块内线性插值 → 开头64ms淡入 + 软限幅
```

---

## 9. 与用户沟通的注意事项

- 回复要短、要有具体数字，用户习惯用 3~10 个字回复（「有」「偏小」「毛刺」）
- 每轮只改一件事，别一次改三处（用户无法分辨是哪个改动起的作用）
- 不要说"再试一次"就完事，要说清这次改了什么、为什么、看到什么数就判定成/不成
- 用户已经测了 10+ 轮，**不要再做无依据的参数试探**，每次改动必须有数据支撑
