liuyiwei1317629/esp32/design/2026-10-27-device-persona-open-questions.md

# 设备人设：待定项记录（2026-10-27）

状态：**身份未定，先记录在案。** 本文件只记事实、现状与待定问题，不做决定。

## 一、已记录的决定

- 2026-10-27，用户要求「先谈人设」，未拍板设备上的人格是谁；明确要求把这个问题记录在案。
- 已向用户提出的第一个问题：**设备上这个声音，是谁？**
  - A. 小鱼本人，语音版单独改写
  - B. 小鱼本人，尽量照原卡搬
  - C. 另起一个角色
  - 用户回答：**待定**（2026-10-27）。

## 二、现状（实测）

- 设备侧人设目前只有一句 120 字通用提示：
  `bridge/config.py:117` → `DEFAULT_PERSONA = "你是一只温柔的陪伴小机器，说话自然口语化，句子短，不用列表和markdown。"`
  并非小鱼。
- persona 长度硬上限 120 字：`context_builder.PERSONA_MAX_CHARS`、`memory_context.PERSONA_MAX_CHARS`；
  `pipeline.py` 在记忆开启/关闭两条路径都注入 `config.DEFAULT_PERSONA`，persona 不可由文件或环境变量替换。
- 小鱼正本卡：`C:\Users\DELL\Downloads\大肥鲸\article-writer\小鱼_情感陪伴角色卡\小鱼-情感陪伴版.md`
  （13,238 字节 / 5,176 字符 / 160 行），为**文字聊天**设计；同目录还有 `小鱼-备忘录.md`、`给小鱼-这几天.md`、
  `角色卡修改意见-2026-10-25.md`（该意见未执行）。

## 三、语音场景的硬约束（谈论任何方案时都要算进去）

1. TTS 会把括号里的动作/语气原样念出来；「（尾巴拍地板）」不能出现在送进 TTS 的文本里。
2. 第 5 节状态块、第 7 节信任分档是文字专用：语音里无法显示，也没有执行器，模型也不该念出来。
3. 第 6 节十二种固定回应表在语音里会显得重复、假；用户 2026-10-25 的修改意见已判定「只留 2–3 句当语气样例」。
4. 没有屏幕：表情、动作、颜文字都无法呈现，只能靠声音和措辞。
5. 桥的切句规则按字数工作（首句 ≥18、第二句 ≥20 且 26 字硬上限、其余 ≥18）。人设若要求「每句 15 字以内」会与切句规则直接冲突，也会拉长首字节与断流风险。
6. 回复形态是 1–3 句口语；Markdown、列表、标题在语音里无意义。
7. 长回复断流问题尚未收口（见 `NEXT-AI-2026-10-27-tts-latency.md`），人设的说话长度会直接影响听感稳定性。

## 四、待定问题清单（按依赖顺序）

1. **身份**：小鱼本人（原卡 / 语音改写版）还是新角色？
2. **记忆与关系**：设备是否共享小鱼已有的记忆与关系？（DSH 侧 `大肥鲸\.mnemon` 与 bridge 侧 `~/.voice-ai/memory` 目前是两套）
3. **注入方式与长度**：语音版人设放在哪（配置文件 / 独立文件 / 环境变量），120 字上限是否放宽、放宽到多少。
4. **称呼**：「用户酱」这个称呼在语音里保留吗。
5. **语气细节**：口头禅（有一说一 / 绷不住了 / 我跟你讲 / 不是吧）、自嘲、嘴硬后补软话，哪些保留。
6. **括号动作的替代**：语音里用停顿、语气词、短句替代，还是干脆不要动作感。
7. **边界与出口**：「别演了／正常回答」立刻出戏；不编「你上次说过」；不拿愧疚逼人——这三条底线在语音里怎么落到提示词。
8. **主动开口**：当前设备只在 `/turn` 被叫时回答，没有主动说话能力；若人设包含主动开口，需要额外的触发机制（未规划）。

## 五、下一步

- 等用户拍板第 1 条后，再按身份方案处理第 2–8 条。
- 在身份未定的前提下，可以先谈「与身份无关」的部分：语音里怎么说话、括号动作怎么处理、称呼与底线。
