liuyiwei1317629/esp32/项目总结.md

# 小鱼语音项目 · 合并总结（截至 2026-10-28）

> 这份文件把以前散在各个 MD 里的**总结类内容**合并成一份，按主题去重、按时间补最新结论。
> 原文都还在，一个字没删；本文件只是把它们读成一份。
> 不含密钥、token、完整对话原文。

## 0. 合并了哪些、没合并哪些

| 处理 | 文件 | 说明 |
|---|---|---|
| 已并入 | `README.md`（根） | 选型、实测数字 |
| 已并入 | `RUNBOOK.md` | 环境、启动、关闭、打包 |
| 已并入 | `bridge/工程日志-2026-10-20.md` | 10-20 工程的经过与结论 |
| 已并入 | `bridge/工程日志-2026-10-28.md` | 记忆诊断与对接待办 |
| 已取要点 | `firmware/README.md` | 硬件、三模式、编译账 |
| 已取要点 | `bridge/README.md` | 接口、大脑路由、实测 |
| **未并入（交接单）** | `HANDOFF.md`、`HANDOVER-G.md`、`NEXT-AI.md`、`NEXT-AI-2026-10-27-tts-latency.md`、`handoff/B·C·F·G` | 按你的要求，交接单不用 |
| 未并入（设计文档） | `design/*.md` | 设计过程稿，不是总结 |

---

## 1. 这是什么

一台 ESP32-S3 语音终端 + 一台 PC 的本地语音陪伴链路。

```
ESP32-S3（麦 ICS43434 / 功放 MAX98357A / ST7789 屏）
   │ 录音 16k 单声道
   ▼
PC bridge :8080
   ├─ ASR   SenseVoice-Small（本机 GPU，约 0.5 GB）
   ├─ LLM   brains.toml 里的 profile → DeepSeek 云 / Ollama 本地
   └─ TTS   肥鱼(WSL) → CosyVoice(Windows) → edge 在线兜底
   │ 16k PCM 流（chunked）
   ▼
设备播放
```

- 设备只做「录 + 放」，理解、生成、合成全在 PC。
- 云端是唯一的人格与长期记忆大脑；本地模型只是功能插件。
- 调试台：`http://127.0.0.1:8080/console`（发文字/录音、看耗时、切大脑、改记忆、一键关闭）。

---

## 2. 现在的状态（2026-10-28）

| 线 | 状态 |
|---|---|
| 声线 | **肥鱼 cute（F6）**为主，链 `feiyu → cosyvoice → edge(晓萱)`；真机在用 |
| 分句 | 26 字硬上限改为「回退到最后一个断点」，最后一句不再消失；真机复验通过 |
| 播放缓冲 | 3 s 缓冲修好长回复断续（`1a14b2a`），**不回退** |
| 记忆 | 五层阶段 1–5 完成、真实目录已启用；10-28 补「每轮一条 event」，**未提交** |
| 屏幕 | 固件 + 推流代码完成并提交（`0ebd1e2` / `ffa1ad1`），**硬件未到货、未上机** |
| 唱歌 | 点播原唱 + 歌单进提示 + 页面音量（30/50/70/100）已实测；10-28 加「歌曲」面板（上传加歌 / 删歌，自动转 16 kHz），固件零改动 |
| 情绪 | 10-28 加本地关键词判断（`bridge/emotion.py`），开口时挑 6 段已有动画之一；**不改提示词、不调模型**，真机未验 |
| 人设 | 10-28 调试台「人设」面板：改 `~/.voice-ai/persona.txt`，上限 **120 字**（与记忆链路同一上限），空着保存=恢复默认，**下一轮生效、不用重启**；默认人设不变 |
| 本地大脑 | Ollama `qwen3.5:2b-q4_K_M`，默认关，断网兜底 |
| 计费 | 调试台顶栏「花费」：今日/本月/累计 + 按大脑拆分，数据来自 `usage.jsonl`；**只读，不设上限** |
| 唤醒词 | **2026-10-28 决定放弃**；只用板载 BOOT 键 |
| 测试 | 43 个 unittest 模块 / **594 例**通过，另有 3 个脚本自检 30 项；每个文件单独进程跑 |
| 推送 | GitHub 仍被墙（`github.com:443` 超时，`ssh.github.com:443` 通但无 key） |

---

## 3. 声线（当前主线）

**FeiyuVoice-CosyVoice3**（Fun-CosyVoice3-0.5B-2512 的小鱼微调，社区叫「肥鱼」）。

- 声线：**cute（F6，`feiyu_cute_F6_0040.pt` + `cute_N01.wav`）**；gentle 试听未选。
- 引擎顺序 `feiyu → cosyvoice → edge`；肥鱼占 3.4–3.6 GB 显存，所以**不与 CosyVoice 同时加载**（`engine.cosyvoice.loading` 恒 False，是设计不是故障）。
- 运行在 WSL2 Ubuntu 24.04；venv `/root/.local/share/feiyu-voice/venv311`；模型 7.0 GB 在 ext4 `/root/feiyu-voice/model`（放 `/mnt/d` 会被 9p I/O 拖到 250 s 加载）。
- 实测：cute RTF **0.66–0.80**（稳态 ≈0.73），gentle 0.83–1.25；加载 90–170 s，启动到 `feiyu.ready` **约 195 s**。
- 参考音 `cute_N01.wav` 是**合成音**（CosyVoice3 → 导出 → Feiyu RVC A60），不是真人录音。
- 首句延迟：已用 `add_zero_shot_spk` 把参考音频特征改成启动时算一次 → 每轮首句 TTS 2.5 s → **0.6 s**；`/api/text` 首句出声 **5.72 s**。
- 剩余延迟大头 = 句长 × RTF（25 字 ≈ 7 s 音频 → 5.3 s 合成），不再优化。
- 运维：`start-console.cmd` 启动时会清掉 WSL 里遗留的 `worker_feiyu.py`；正常关闭（调试台「关闭」/`/shutdown`）会连带 `pkill`；`tts.stop()` 已移入 `finally`，异常退出也收尾（`a884119`）。

> 历史：10-20 时「说」是 CosyVoice-300M-SFT，RTF 0.96–1.22、流式首包 2.46 s（fp32）。10-28 起主线换成肥鱼，CosyVoice 退为第二档。

---

## 4. 设备端

### 4.1 硬件与接线

- 板子：ESP32-S3（N16R8 类），两路独立 I2S：麦 ICS43434、功放 MAX98357A。
- 屏幕（10-28 加，未上机）：2.4 寸 **ST7789，8 针无 MISO**；**电源两针各接一处，不用一分二**。
- 供电：两根 USB（供电 + 串口）同机共地；不要用 9V/12V 多档充电头。
- 烧录口是 **CH343**（板上 COM 口），不是 CDC。`arduino-cli` 在 D 盘，必须带 `--config-file`，端口多为 COM5。

### 4.2 三种模式（都已上机验证）

| 模式 | 状态 |
|---|---|
| RECORD_ONLY | 2026-10-26 定稿 |
| TURN | 2026-10-27 跑通 |
| TURN_STOP | 2026-10-27 跑通（播报中按 BOOT 打断） |

操作：IDLE 按住 BOOT 录音，松开发送；静音 1.2 s 自动结束；最长 15 s；短于 0.3 s 丢弃；首字节那 2–4 s 内按键不响应。

### 4.3 音频定稿（不要动）

- `TARGET_RMS=2700` / `GAIN_MAX=8.0`，2026-10-26 `snapshots/2026-10-26_final-v3/` 定稿。
- 历史大错已修：① 烧录口不是 CDC 是 CH343；② `compThr` 阈值参照系 bug 才是「增益乱跳」的真身。
- 底噪/杂音的唯一主因是地线，**不要靠改音频参数解决**。
- 26 字是句子硬上限；到上限时回退到最后一个断点，不再按字数生切。

### 4.4 屏幕（代码完成、未上机）

- 固件 + bridge MJPEG 推流都写完并提交（`0ebd1e2` / `ffa1ad1`），含屏后 **flash 84%**，528 例测试通过。
- 推流需要 WSL 里的 ffmpeg；Windows 侧没有 ffmpeg。
- 上机验收清单在 `design/2026-10-28-screen-stream-plan.md` §9，等硬件到货。

---

## 5. PC 端：大脑与记忆

### 5.1 大脑路由

- profile 在 `~/.voice-ai/brains.toml`；DeepSeek 云端为主，Ollama 本地兜底（默认关）。
- 本地大脑实测：热身后首字 ≈1.3 s、首段音频 ≈8 s（大头是肥鱼合成），适合兜底不适合日常。
- `reasoning_effort = "none"` 是关思考的唯一有效写法（`think=false` 无效）。
- 用量账本 `~/.voice-ai/usage.jsonl`；密钥只在 `~/.deepseek/`，不进工作区。

### 5.2 规则命令

`stop / time / timer` 在 `pipeline.Turn` 里本地短路，不调云端。这类回合**故意不写记忆**（不落 facts、不进 recent_cache、不记账本）。

### 5.3 五层记忆

| 层 | 内容 | 现状 |
|---|---|---|
| L1 | 当前输入（≤500 字） | 正常 |
| L2 | 会话摘要 + sticky（≤100 / ≤20） | 正常，`dev1` 累计 37 轮 |
| L3 | 检索 | 正常 |
| L4 | 有效事实 facts | 长期为 0：提取器是纯正则，只认「我叫…／我喜欢…」等固定句式 |
| L5 | 经历 episodes | **原来没有写入点**，10-28 补上 |

- 写路径：`MemoryWriter` 单 daemon worker、队列 64、dry-run 默认；`start-bridge.cmd` 才开真实写（`MEMORY_ENABLED=1`、`MEMORY_DRY_RUN=0`）。
- 预算：1050 tokens/轮硬上限；读路径 p95 ≤20 ms 达标（实测 1.3–2.1 ms）。
- 容量：facts 上限 200、episodes 上限 500；满了按（命中少 + 最久未用）淘汰。

**10-28 诊断「调试台记忆 0 条」**——不是开关机清零：

| 判断 | 证据 |
|---|---|
| 文件跨重启存在 | 10-22 的会话文件今天仍在；目录在 C 盘 |
| 有效事实 0 条 | 唯一那条已在 10-28 10:56 通过调试台删除打成 tombstone |
| 经历 0 条 | `episodes.jsonl` 从未生成，生产代码没有写入点 |
| 开关正常 | 日志 `memory: enabled ... dry_run=False` |

**10-28 改动（未提交）**：`_write_turn_episode()` 每轮成功写一条 `kind=event`、`source=turn`，正文 `用户：… ／ 我：…`（各截 60 字）；配套 TDD 用例；529 例全绿；**重启 bridge 后对新回合生效**。

### 5.4 和「人格记忆」项目对接（等那边完工再做）

- 那边是**语义权威**，这边是**对话流水**；不要让两边都当真。
- 要补 3 个字段（schema 变更，需单独授权）：`turn_id`（或 `session_id`+`gen` 做幂等键）、`session_id`、user/assistant 拆两个字段。
- 摄取：先走文件（定期读 `episodes.jsonl`），再考虑 `GET /api/memory/episodes?since=`；**不要两进程共享同一个库文件**。
- **必须过滤 `status=tombstone`**，否则用户让设备忘掉的事会在另一个库被重新记起来。
- 容量风险：每轮一条约十天填满 500，且 todo 比闲聊更先被淘汰 → 长期权威必须留在人格项目那侧。
- 明确不做：双写；不改正则提取器。

---

## 6. 运行环境与启动

### 6.1 环境

| 项 | 本机实况 |
|---|---|
| 系统 | Windows 11 x64 |
| 显卡 | RTX 3060 Laptop 6 GB |
| Python A | 3.13 → `.venv/`（ASR + bridge） |
| Python B | 3.11 → `py311/`（CosyVoice worker） |
| WSL | Ubuntu 24.04（肥鱼只能在 Linux 下跑） |
| Ollama | `D:\ollama\ollama.exe`，`127.0.0.1:11434` |
| 端口 | 8080 / 11434 |

显存：肥鱼 ≈3.4 GB + SenseVoice ≈0.5 GB；再开本地大脑 → 5.7/6.1 GB，很挤，不建议长期同时跑。

### 6.2 启动与关闭

- **日常**：双击「小鱼调试台」→ `start-console.cmd`：查 11434 → 清 WSL 孤儿 worker → 起 `start-bridge.cmd` → 等 8080 → 开 Edge。
- **手动**：`start-bridge.cmd [--mic --play | --no-feiyu | --brain local]`。
- **关闭**：调试台「关闭」= `POST /shutdown`（仅本机 + token），打断当前轮、退 bridge、`pkill` 肥鱼 worker。
- 冷启动到 `feiyu.ready` ≈195 s（热 60 s）；`engine` 胶囊变绿即可用。

### 6.3 打包带走

- 带：`bridge/`、`models/`、`CosyVoice/`、`py311/`、`firmware/`、两个 `.cmd`、`brains.toml`（改 key 路径）。
- 不带：`.venv`（路径写死，重建）、任何密钥、`console/turns.jsonl`、`memory/`。
- 目标机重建：两个 venv、两个密钥文件、WSL 侧 7 GB 肥鱼、可选 Ollama、固件 `secrets.h`。

### 6.4 排障一眼表

| 现象 | 先查 |
|---|---|
| 页面打不开 | `netstat -ano \| findstr :8080` |
| 有字没声 | `/api/state` 的 `engine.feiyu.ready`；`bridge/logs/feiyu.log` |
| 肥鱼加载失败 | WSL 里 `pgrep -af worker_feiyu.py`；`nvidia-smi` 显存 |
| 回复为空 | 本地大脑是否 `reasoning_effort = "none"` |
| 局域网不能录音 | 浏览器麦克风只在 `127.0.0.1` / https 下可用 |
| 设备连不上 | PC 局域网 IP 变了（DHCP）；`bridge_token` 不一致 |

---

## 7. 工程日志（历史）

### 7.1 2026-10-20（ZCode 会话）

- 真 key 就位 → `test_live.py` 真全链两轮绿灯：真 ASR(CPU) → 真 deepseek-flash 流式 → 切句 → CosyVoice → chunked PCM + 真 barge-in。
- 合成变慢（210→450 ms/字）→ `throttle_probe.py` 三阶段归因：热节流、内存压力、bridge 层全部排除，是整机低时钟低功耗状态（夜里 250–460 vs 下午 125–206）。
- 追加交接（01:40）：两个 worker 以 GBK 写 / UTF-8 读 JSON-lines，中文全乱码、每句静默回落 edge —— 改显式 UTF-8 + `PYTHONIOENCODING` + 加载期自预热「好。」（首调 2694 → 1705 ms）+ `COSYVOICE_TIMEOUT` 6→9 s。
- 当夜实测：单句 125–243 ms/字、RTF 0.84–1.5、显存 ≈2.0 GB、加载 14.9–19.9 s、内容回读 5/5 逐字一致、e2e 首字节 1918/1654 ms。
- 两处自我撤回（别当事实传）：①「可用内存只剩 0.21 GB 是硬约束」是误报；② e2e 里 `/stop` 的闭流秒数不是打断指标。

### 7.2 2026-10-28（记忆）

见 §5.3 与 `bridge/工程日志-2026-10-28.md`：不是开关机清零，是根本没写进去；当天补了 event episode，接入人格项目的四件事留到那边完工。

---

## 8. 已放弃 / 被否的路线（别再重提）

| 事项 | 结论 |
|---|---|
| 设备端唤醒词「小鱼」 | 2026-10-28 **放弃**。板端唤醒词编译期固定，只有 "Hi ESP"；中文命令识别未编入；逆向核心也改不了 |
| 统一 24–30 字句长 | 已试过并被否（听感碎），已回退 `84233a5` |
| fp16 加速 | 负优化：整句 7.18 s vs fp32 5.73 s，加载也更慢 |
| 3 s 播放缓冲 | 保留，不回退 |
| BreezeBlue TTS | 2026-10-28 提议后取消，未写代码 |
| 本地自己唱（RVC/SVS） | 评估过，未批准；SVS 需 2.82 GB 权重 + 自备对齐参考 |

---

## 9. 还没做完

1. 人设词界面：代码和测试完成，**未提交**，等你点头（加歌 + 情绪已提交 `8f6a46d`）。
2. 重启 bridge：episode 写入、`/api/usage`、加歌、情绪动画、人设词都要重启才生效。
3. 屏幕硬件到货 → 上机验收（`design/2026-10-28-screen-stream-plan.md` §9），情绪动画一起看。
4. 人格记忆项目完工 → 按 §5.4 补 3 字段、文件摄取、tombstone 过滤。
5. GitHub 推送：SSH key 已生成（`~/.ssh/id_ed25519`，`ssh.github.com:443`），差你把公钥贴进 GitHub 账号。
6. 可选：`nvidia-smi -pl` 限功耗。

---

## 10. 硬约束（任何时候都别破）

- 不读 `secrets.h`、不打印 token、不烧录、不下单、不开新分支、不换分区。
- 不改音频参数（`CLIP_TARGET_RMS` / `CLIP_GAIN_MAX`）、不回退 3 s 播放缓冲。
- 密钥只在 `~/.deepseek/`，不进工作区、不进备份、不进任何文档。
- 测试不能用 `unittest discover` 跑全目录：`test_live` / `test_e2e` / `test_edge_content` 一导入就发真请求（有的一导入就起 CosyVoice 花显存和云额度）。
- voice-ai 没有 git 身份，提交用 `git -c user.name=DELL -c user.email=dell@local commit`；提交前先问。
