liuyiwei1317629/esp32/NEXT-AI-2026-10-27-tts-latency.md

# 交接单：TTS 速度 / 长回复断续（2026-10-27）

> 本文件只覆盖「长回复播放断续」这一条线，以及它牵出的 TTS 速度问题。
> 全量项目状态仍看 `HANDOFF.md`（契约与验收）与 `NEXT-AI.md`（PC/硬件总览）；`NEXT-AI.md` 中与本文件重叠的状态已按本文件更新。

## 交接区

- 交接编号：PH-20261027-voice-latency-01
- 源任务：60c064d3-d8b9-4f32-ac7f-ef1676fc0ed7
- 项目目录：`C:\Users\DELL\voice-ai`
- 用户确认范围：先暂停、不改结果，只整理交接材料
- 交接状态：**已真机验收、已提交（2026-10-27 10:37，`1205609`）**。根因修正为「开局赤字 = 合成(第二句) − 音频(第一句)」，与「最短字数」无关。已采用：首句 ≥18 字、**第二句 ≥20 字且在逗号处切、26 字硬上限**、第三句起 ≥18 字。真机：69.1 s 回复 **0 次断流**（修前同链路 46 次 / 1.47 s），24–81 s 共 8 轮断流 0–5 次，首字节 4.4–5.2 s。提交只含本线代码与本文档；`HANDOFF.md` / `NEXT-AI.md` / 两个 README 等与另一条线交叠的文档仍留在工作区。
- 更新时间：2026-10-27 10:45

## 1. 现在要做什么，最后交什么

**要做的事**：让 55 秒级的长回复在 ESP32 上播放时不再出现听得出来的断续。当前真机是 46 次、约 1.47 秒静音（占 2.6%），已经落在回复开头几秒。

**最后交什么**：一版可以提交的改动（bridge 侧 + 必要时固件），加上真机实测数据、文档同步。不是「某个数字变好」就算完。

**完成标准**（Agent 建议，用户未逐条确认）：真机跑一条 50 秒以上的回复，`underruns ≤ 10`（静音 ≤ 0.32 秒）、全程不切换引擎、不超时、录音侧 `voice=1`。`first_pcm_ms` 实测 4.4–5.5 s（原 2500 的目标已随用户选择作废，3.5–4.2 的预估也被真机推翻，见 §3.15）。**当前状态：完成标准已达到**（72.5 s 回复 5 次断流 / 160 ms）。

**不做**：不改音频调音参数（`CLIP_TARGET_RMS` / `CLIP_GAIN_MAX` 是定稿值）；不回退 3 秒播放缓冲。

## 2. 最新的要求，哪些旧要求已作废

- **最新（用户 2026-10-27）**：用户让我全权负责，并取消「每个对话只负责一块」的限制 → bridge 代码由本线直接负责；跨会话的文件界限取消。
- **最新（用户，同一天稍后）**：「先暂停，不要改结果。」→ 交接期间不动代码、不动固件、不跑 GPU 任务。
- **作废（被上面第一条取代）**：
  - 「不要跑 GPU 任务」「GPU 任务需授权」作为常态限制不再成立；当前 GPU 空闲，但起 CosyVoice 仍应先问一句（会占约 2 GB 显存）。
- **仍有效**：打断只在出声后生效；`secrets.h` 不读不覆盖；`~/.deepseek/key`、`bridge_token` 只确认存在不打印；录音/记忆明文不上传。
- **作废（用户 2026-10-27 选定路线 B）**：「首字节 1.5–2 秒」不再是硬目标——为了让开头 8 秒不缺音频，首句必须够长，首字节接受 4–5 秒。1.5–2 秒留作以后拆 TTS 固定开销的长期目标。
- **修正（2026-10-27 真机）**：路线 B 当时承诺的「首字节 3.5–4.6 秒、空档消失」**只对了一半**——真机首字节 4.4–5.5 s（比预估多约 1 s），而且单靠「最短 18 字」在部分回复上仍会掉 0.7–1.4 s。补充规则见 §3.15。
- **未决**：对外契约（`/turn` 加字段或新端点）由用户确认；若下一步需要改响应头或端点，先问一次，不要自行决定。

## 3. 已确认的事和依据

1. **固件 3 秒播放缓冲已落地并在真机验证。** 提交 `1a14b2a`（HEAD，未推送）。`firmware/voice_terminal/config.h:71` 是 `PLAY_STREAM_BYTES_MAX = 98304`，失败时逐级回退；开机日志打印 `play_buf=98304B`。真机 55.7 秒回复：`underruns=46`（≈1.47 秒，2.6%），修复前同一指标在 7.1 秒回复上是 59 次（27%）。当前烧的就是这版干净固件（COM5 / CH343）。
2. **Windows 后台效率模式（EcoQoS）会把 TTS 进程压到约一半速度。** 同一脚本、同一环境、同一句话，A/B 对照：
   - 不清节流位：RTF `1.77 / 1.87 / 1.81`
   - 清掉 `PROCESS_POWER_THROTTLING_EXECUTION_SPEED`：`0.847 / 0.776 / 0.804`
   依据是原始 JSON 输出（本会话接手时从源会话工具结果核对），不是口述。
3. **修复已进代码。** 新增 `bridge/winperf.py`（调 `SetProcessInformation`）+ `bridge/test_winperf.py`；`server.py` 的 `main()`、`worker_cosyvoice.py`、`worker_edge.py` 启动时各调用一次。集成后 worker 实测 RTF `0.72 / 0.714 / 0.723`，不再偷偷切到 edge。CI 的 `hermetic.yml` 已登记 `test_winperf`。
4. **真实 bridge + 模拟播放器（非真机）的基线。** 同一套固定 8 句回复、真实 CosyVoice 合成、固件播放模型（160 ms 起播水位、98304 B 缓冲、32 ms 帧）：首字节 2.05–2.11 秒，35–36 秒音频里 `underruns` 55–62（每次 32 ms，约 1.76–1.98 秒、5.6%），缺口全部落在 4–8 秒。
5. **切句变体实验的结果（同一实验，两次运行）**：
   - `min18`（所有句子最少 18 字）：首字节 3.715 秒，`underruns=1`（0.03 秒）
   - `min22`：首字节 4.618 秒，`underruns=25`（0.8 秒）
   - 两者切出来的句子完全相同（23/31/28/35/23/25/31/22 字），说明单次结果波动很大。
6. **测试门全过（本次接手会话复跑）**：19 个 unittest 模块 `Ran 381 tests ... OK`（6.6 秒，含 `test_winperf`、`test_local_plugin`）；`test_sentence_split.py` 8/8、`test_llm.py` 9/9、`test_pipeline.py` 10/10。
7. **当前运行状态**：没有 python 进程，8080 无监听，GPU 0 MiB；bridge 和 Ollama 都没起（起 bridge 用 `start-bridge.cmd`，把 CosyVoice 冷加载约 15–17 秒）。
8. **工作区把两条线混在一起。** `bridge/server.py`、`worker_cosyvoice.py`、`worker_edge.py`、`hermetic.yml` 同时含「本地应急兜底（另一条线）」和「winperf（本线）」的改动；`bridge/pipeline.py`、`config.py`、两个 README、`test_pipeline.py`、`test_memory_integration.py` 属于另一条线。提交前分开看，不要 `git add -A`。
9. **端到端 A/B：节流开 → 关 → 开 → 关（2026-10-27，真实 CosyVoice + 播放模型，同一条 8 句回复）。**

   | 轮次 | 节流位 | 首字节 | TTS RTF | 断流次数 | 静音 |
   | --- | --- | --- | --- | --- | --- |
   | A1 开 | 1 | 13.06 s | 5.20 | 4639 | 148.5 s（跑满 201 s） |
   | B1 关 | 0 | 2.22 s | 0.90 | 54 | 1.73 s（4.8%） |
   | A2 开 | 1 | 10.96 s | 5.22 | 4623 | 147.9 s（跑满 198 s） |
   | B2 关 | 0 | 2.32 s | 0.84 | 57 | 1.82 s（5.0%） |

   结论：**节流是真实且巨大的杠杆**（RTF 5.2 对 0.87，断流 4600+ 对 55），必须保持修复；但**修好之后残余仍有 54–57 次、4.8–5.0%**，与修前模拟基线（55–62 次）一致——**开头那 1–2 秒缺口不是 TTS 速度造成的**。节流臂的静音百分比超过 100%，因为合成比播放还慢，百分比在该臂没有意义，只看断流次数与整轮耗时。

10. **切句策略 A/B：基线与混合交替两轮（2026-10-27 09:2x，同一 harness、同一条回复，节流位全程为 0、引擎全程 cosyvoice）。**

    | 轮次 | 后续最短 | 首字节 | 切出的句子（字） | 单句合成最长 | RTF | 断流 | 静音 |
    | --- | --- | --- | --- | --- | --- | --- | --- |
    | S1 基线 | 8 字 | 2.00 s | 13/14/35/33/39/26/28/35/25 | 4.16 s | 0.78 | 53 | 1.70 s（4.8%） |
    | H1 混合 | 18 字 | 2.18 s | 13/47/35/39/26/28/35/25 | 5.88 s | 0.83 | 121 | 3.87 s（10.1%） |
    | S2 基线 | 8 字 | 2.48 s | 与 S1 相同 | 6.04 s | 0.97 | 105 | 3.36 s（8.9%） |
    | H2 混合 | 18 字 | 2.18 s | 与 H1 相同 | 5.04 s | 0.87 | 97 | 3.10 s（8.8%） |

    结论一：**混合切句不成立**。合并出来的 47 字句子单次合成 5.0–5.9 秒，断流从 53–105 升到 97–121。
    结论二：**这轮实验按预设标准无效**——同一配置的 S1 与 S2 相差 52 次（53 对 105），比两种策略之间的差还大；单次结果不能当结论，下结论前至少要 3 轮取中位数。
    ~~结论三：缺口来自「每一次句间切换」~~ —— **此条已被 §3.11 的轨迹实测推翻**，保留原文只为对照：当时把 `last_underrun_at`（回复末尾一次孤立事件）误当成持续断流的证据。真正的分布见 §3.11。

11. **缓冲水位轨迹 + 6 秒缓冲对照（2026-10-27 09:5x，fp16 关，每 0.5 秒记录一次水位）。**

    | 轮次 | 缓冲 | 断流 | 断流时刻分布 | 缓冲首次填满 |
    | --- | --- | --- | --- | --- |
    | T1 | 3 s | 62 | 3.90–4.13 s 共 8 次；6.33–8.01 s 共 53 次；39.83 s 1 次 | 8.04 s |
    | T2 | 6 s | 57 | 6.36–8.14 s 共 54 次；末尾 1 次 | —（6.5–8.1 s 水位为 0） |

    结论：**6 秒缓冲不改善（57 对 62），因为开头那段音频还没被合成出来**。逐句数据：13 字句合成 1.93 秒、只产出 2.0 秒音频；14 字句 2.15 秒产出 2.2 秒；第三句 35 字要 3.90 秒，到 8.0 秒才整段到达，而播放从 2.0 秒起、6.4 秒就把前两句放完 → 固定约 1.7 秒空档。8.2 秒之后水位在 0.5–3 s 之间波动，**再没断过一次**（除末尾）。所以这是「前 8 秒造不出音频」的启动赤字，不是缓冲容量问题，也不是句间持续断流。
    单次调用的固定开销：13 字 1.93 秒（RTF 1.33）、35 字 3.90 秒（0.53），拟合约 **1.9 秒 + 60 毫秒/字**。profiler（13 字一次调用）显示 GPU 1.87 秒、CPU 1.69 秒、4000+ 个小 kernel —— 既吃算力也吃 launch 开销；autocast fp16 换不来提速（§3.12）。

12. **fp16 试过，没有收益（2026-10-27 09:4x）。** `CosyVoice(..., fp16=True)` 走 `torch.cuda.amp.autocast`；worker 自报 `fp16: true`，模块仍在 `cuda:0`（`torch 2.3.1+cu121`、`cuda_avail True`、RTX 3060 Laptop、显存 2.4 GB）。三轮：断流 86/46/83、RTF 0.914/0.918/0.928，单句最长 4.93/4.79/4.76 秒 —— 与 fp32 的 53/105（最长 4.16/6.04 秒）同一噪声带，没有变快。**默认已关**（`config.COSYVOICE_FP16` 默认 0，可用环境变量打开）。
13. **流式合成在节流修复后重测，仍然否定。** 首块 2.84–3.60 秒（整句是 2.0–2.3 秒），且块累计到达的 RTF 1.09–1.63，比播放还慢，流式会持续断供。
14. **已采用：所有句子 ≥18 字（首句含），模拟 3 轮复测通过（2026-10-27 12:xx）。** 改动：`bridge/config.py` 的 `SENTENCE_MIN_CHARS` / `SENTENCE_FIRST_MIN_CHARS` 默认 18；`Turn.__init__` 把它们传给 `SentenceSplitter`（`sentence_split.py` 的类默认值仍是 8/5，不动，免得它自己的测试失真）；`test_pipeline.py` 的流式片段改成两条 ≥18 字句子。**注意：这条模拟结论在真机上只部分成立——见 §3.15。**

    | 轮次 | 首字节 | 断流 | 静音 | 切出的句子（字） | RTF |
    | --- | --- | --- | --- | --- | --- |
    | M1 | 3.555 s | 3 | 0.10 s | 27/35/33/39/26/28/35/25 | 0.812 |
    | M2 | 3.651 s | 6 | 0.19 s | 同上 | 0.840 |
    | M3 | 3.733 s | 1 | 0.03 s | 同上 | 0.823 |

    对照基线 S1/S2（§3.10）与轨迹轮 T1（§3.11）：53 / 105 / 62 次。首字节从 2.0–2.5 s 涨到 3.56–3.73 s，与 §3.11 的算术一致（首句长了，第一次合成就能交出 4 秒以上音频）。三轮波动只有 5 次，比 8 字基线的 52 次小得多——顺带说明 §4.7 的「单次波动」主要来自短句把系统推到水位 0 的边缘。测试（2026-10-27 12:4x 复跑）：19 个 unittest 模块 `Ran 381 tests ... OK`，三个脚本自检 8/8、9/9、10/10。

15. **真机验收（2026-10-27 10:0x–10:2x）：根因是「开局赤字」，不是「最短字数」。** 加了逐句遥测（`TTS_TRACE=1`，`pipeline._tts_stage` 打 `chars/wall_ms/audio_ms/at_ms`）后，四轮真机数据全部落在同一个公式上：

    **缺口 ≈ max(0, 句间停顿 + 合成(第二句) − 音频(第一句))**

    因为首句是**合成完才发的整段突发**，播放一开始手里就握着整句音频；水位只决定"多晚开播"，不改变这份存款。

    | 轮次（配置） | 首句→第二句 | 首句音频 | 第二句合成 | 预测 | 实测断流 | 回复时长 |
    | --- | --- | --- | --- | --- | --- | --- |
    | 09:47（≥18） | ~22 → ? | 3.4 s | ~4.2 s | −0.8 s | 45 次 = 1.44 s | 78.9 s |
    | 10:0x #1（≥18） | 29 → 40 | 4.54 s | 4.26 s | +0.28 s | 0 | 62.8 s |
    | 10:0x #2（≥18） | 26 → 38 | 4.44 s | 4.36 s | +0.08 s | 0 | 78.1 s |
    | 10:0x #3（≥18） | 31 → 37 | 4.10 s | 4.78 s | −0.68 s | 23 次 = 0.74 s | 22.8 s |
    | 10:1x #4（新规则） | 24 → 30 | 3.96 s | 4.24 s | −0.28 s | 5 次 = 0.16 s | 72.5 s |

    单句经济学（真机）：音频 ≈ 155–170 ms/字，合成 ≈ 110 ms/字 + 0.6 s 固定；所以只有 18–21 字的句子是"刚好不亏"，22 字以上每句净赚 0.4–2 s（这正是中段不卡的原因，句间 0.6–1.8 s 的 LLM 停顿由 3 s 缓冲吸收）。

    **抬水位无效（已试并回退）。** 把 `PLAY_PREBUFFER_BYTES` 5120 → 57600（1.8 s）重烧，同一批回复仍按公式掉 23 次（首句 31 / 第二句 37）；因为首句突发一次性到齐，1.8 s 水位在几十毫秒内就满足，不再增加任何存款。固件已回退到 5120，`config.h` 里留了注释说明原因。

    **已采用的补丁：第二句 ≥20 字且允许在逗号处切**（`SENTENCE_SECOND_MIN_CHARS=20`，`sentence_split.py` 给第二句额外开了 weak break）。首句 ≥18 字不变（首字节不动），第三句起回到 ≥18 字 + 只在句号处切。效果：把上表的 −0.68 s 压到 −0.28 s（5 次断流）；短回复（7.2 s、5.0 s 两轮）都是 0 次。

    **再补一刀：第二句 26 字硬上限（`SENTENCE_SECOND_MAX_CHARS=26`）。** 上一条只靠标点，遇到 30 字一口气的第二句仍会掉 0.28 s（5 次）。26 字上限让 `合成(第二句) ≤ 3.46 s`，自然首句 21–31 字的音频是 3.3–4.8 s，缺口必然 ≤0。没有选「把首句抬到 24」——那轮首句本来就是 24 字（第一个标点就在 24），抬门槛只会把首句推到下一个标点、可能一下变成 40 多字、首字节 +2 s。**代价**：第二句若 26 字内无标点会被强切，句中多一个停顿（用户 2026-10-27 听过后表示可以接受）。真机复测：69.1 s 回复 **0 次断流**、首字节 5.20 s。

## 4. 还没验证的推测

1. **EcoQoS 修复在真机上「生效」，但没有真机 A/B。** 今天所有真机回合都跑在修复后的进程上（首字节 4.4–5.5 s、单句合成 RTF≈1.1），没有再出现修前的 11–13 s 首字节；但真机上没做「关节流位」的对照，只有模拟器端到端 A/B（§3.9）。
2. **「第二句缩短就能封死开局赤字」—— 真机只验了 1 轮（§3.15）。** 24→30 字那轮从 23 次降到 5 次，方向对，但样本只有一条长回复；LLM 第二句若 20–40 字无标点，规则切不开，残余缺口最坏约 0.5 s。需要再跑 1–2 条长回复确认。
3. **「怎么降低单次调用的 1.9 秒固定开销」还没定。** profiler 只到算子级（GPU 1.87 秒、CPU 1.69 秒、4000+ 小 kernel），没拆到 llm / flow / hift 各占多少；`torch.compile`、`load_jit`、`load_trt`（都需要配套引擎文件）都没试过。
4. **双路并行合成没测。** 理论上第二、三句可以并行，保住 2 秒首字节；但 6 GB 显存要放两份 2.4 GB 模型，且并发会让每路变慢，净收益未知。
5. **进程级 unthrottle 的副作用没测。** 主进程（SenseVoice 在 CPU）也叫了 `unthrottle()`，对 ASR 延迟和功耗的影响未知；edge worker 的那次调用没有单独测。
6. **模拟器和真机的差距未知。** 模拟器没有网络抖动、没有 FreeRTOS 调度、没有 Wi-Fi 丢包重传，两边的静音比例不能直接比（真机 2.6%，模拟器 4.8–10.1%，回复也不同）。
7. **单次实验波动来自哪里 —— 未查明。** 同一配置两轮差 2 倍（53 对 105、单句合成 3.45 对 6.04 秒），还没定位是 GPU 温频、驱动调度还是句内文本差异。

## 5. 试过不行的路和原因

| 路线 | 结果 | 原因 |
| --- | --- | --- |
| CosyVoice 逐块流式（`stream=True`） | 否定 | 首块 5.5 秒、RTF 2.8，比整句（2.18）更慢，首字节反而更差 |
| 弱断句：逗号也切（weak 16/22/26） | 否定 | 句子变短后每次合成都接近实时（RTF≈1），缓冲永远建不起来，比基线更差 |
| 混合切句：首句 5 字、后续 ≥18 字 | 否定（2026-10-27） | 相邻短句被并成 47 字长句，单次合成 5.0–5.9 秒，断流 53–105 → 97–121（§3.10） |
| 继续加深播放缓冲（超过 3 秒） | 否定（2026-10-27 模拟） | 6 秒缓冲仍 57 次（3 秒 62 次），断流全在 6.3–8.1 秒且那时水位本来就是 0 —— 开头音频还没造出来，加深缓冲没有意义（§3.11）。是否改 PSRAM 分配留待真机验证时再定 |
| fp16 推理（autocast） | 否定（2026-10-27） | worker 确认 `fp16: true`、模型在 cuda:0，但 RTF 0.91–0.93 与 fp32 同一噪声带，单句最长仍 4.8–4.9 秒（§3.12） |
| 流式合成（`stream=True`）重测 | 仍然否定 | 首块 2.84–3.60 秒，块到达 RTF 1.09–1.63，跟不上播放（§3.13） |
| 抬起始水位 `PLAY_PREBUFFER_BYTES` 160 ms → 1.8 s | 否定（2026-10-27 真机） | 首句是整段突发，水位在几十毫秒内就满足，不增加任何开局存款；同批回复仍掉 23 次。固件已回退（§3.15） |
| 怀疑 GPU（频率/显存/算力） | 排除 | matmul 微基准 7.02 TFLOPS 正常，GPU 能 boost、显存没溢出——慢的不是显卡本身 |
| 只绑大核（CPU affinity） | 不是主因 | 绑核那组 RTF 1.106/1.006/0.865，波动大；真正稳定的杠杆是清节流位（0.78–0.85 对 1.77–1.87） |

## 6. 下一步最小的一件事，做到什么样算合格

**已完成（2026-10-27）：节流 A/B（§3.9）、混合切句 A/B（§3.10）、缓冲轨迹（§3.11）、fp16（§3.12）、流式重测（§3.13）、所有句子 ≥18 字三轮模拟（§3.14）、**真机验收与第二句规则（§3.15）**。**

**已完成（2026-10-27 10:2x–10:4x）：真机验收** —— 72.5 s 回复 5 次断流（160 ms），补 26 字上限后 69.1 s 回复 **0 次**；62.8 / 78.1 / 81.4 / 22.8 / 7.2 / 5.0 / 2.9 s 七轮 0 次；首字节 4.4–5.2 s。对照修前 46 次 / 1.47 s（2.6%）。

**代码状态**：`config.py` 新增 `SENTENCE_SECOND_MIN_CHARS=20` / `SENTENCE_SECOND_MAX_CHARS=26`；`sentence_split.py` 新增 `second_min_chars` / `second_max_chars`（类默认值不变：`None` 时分别等价于 `min_chars` / `hard_max_chars`）；`pipeline.py` 透传并把临时逐句遥测挂在 `TTS_TRACE=1` 下。**已提交 `1205609`**（只含本线 14 个文件）。提交树上复跑：18 个 unittest 模块 **373 例** + 三个脚本自检 **25 例**（sentence_split 10/10、llm 9/9、pipeline 6/6）全绿——工作区里的 381/29 是因为另一条线加了本地兜底用例与 `test_local_plugin`。

**下一步**：另一条线（本地应急兜底 + 记忆状态行）的代码、`HANDOFF.md` / `NEXT-AI.md` / 两个 README 等交叠文档仍在工作区，等它定稿后单独提交。固件的 `config.h` 本次只提交了三行注释（数值未变，板子上跑的就是这个值）。

**前置条件**（若再测）：GPU 空闲、约 3–4 分钟、起 CosyVoice 占约 2 GB 显存、COM5 空闲、板子在线。

## 权威资料

| 路径 | 管什么 |
| --- | --- |
| `HANDOFF.md` | 权威全量：契约、验收、PC 端细节。§1.1–§1.3、§2、§9 |
| `NEXT-AI.md` | PC/硬件总览；与本文件重叠的状态已按本文件更新 |
| `HANDOVER-G.md` | 硬件与音频定稿（接线、烧录、地回路、调音参数） |
| `bridge/README.md` | 桥的实现、性能、测试与运维 |
| `firmware/README.md` | 固件尺寸表、上机验证、供电与接线 |
| `bridge/config.py:96` | `COSYVOICE_TIMEOUT = 9.0` |
| `firmware/voice_terminal/config.h:71` / `:77` | 3 秒缓冲上限 / 160 ms 起播水位 |
| `bridge/sentence_split.py` / `bridge/config.py:106-108` | 首句/第二句/后续句的字数门槛 |

**临时脚本（不持久，可能已被清理）**：`C:\Users\DELL\AppData\Local\Temp\` 下的 `devsim_probe.py`（真实 bridge + 播放模型，单轮）、`devsim_ab.py`（节流开/关四轮对照）、`devsim_split.py`（切句策略四轮对照，带缓冲水位/单句耗时遥测，`SIM_TRACE=1` 开会记全程水位）、`devsim_fp16.py`（fp16 三轮）、`devsim_buf6.py`（6 秒缓冲三轮）、`devsim_trace.py`（3 秒 vs 6 秒轨迹）、`devsim_device.py`（device/显存/单次耗时）、`devsim_stream.py`（流式节奏）、`devsim_profile.py`（算子级 profiler）、`devsim_variants.py` / `devsim_variants2.py`（早期切句策略对比）。它们都不在仓库里，需要时得重建：固定回复按 6 字一段喂给 `pipeline.Bridge`，消费端按 160 ms 预缓冲 + 98304 B 缓冲 + 32 ms 帧消费。

## 开场白（给新对话）

```
project-handoff 恢复。项目 C:\Users\DELL\voice-ai；来源 NEXT-AI-2026-10-27-tts-latency.md 交接编号 PH-20261027-voice-latency-01；已定案并提交（`1205609`）首句 ≥18 字 + 第二句 ≥20 字（允许逗号切）+ 26 字硬上限 + 第三句起 ≥18 字，真机 69.1 s 回复 0 次断流、首字节 4.4–5.2 s；目标 收尾（本线已收口）；限制 不改音频调音参数、不加深 3 秒缓冲、不改固件（已回退到 160 ms 水位）、不要 git add -A；下一步 另一条线（本地应急兜底 + 交叠文档）定稿后单独提交；第一步 先只读核对 `git status` 与本文档。
```
