liuyiwei1317629/esp32/(commit log)

2026-10-21 feat: 新增 C 包规则命令解析与测试
    为本地语音 bridge 提供离线、无副作用的整句命令解析：stop/time 整句匹配，timer 解析数字与时间单位；仅解析不执行，不承诺到点自动提醒。
2026-10-22 feat: 接入五层记忆读取与 dry-run 写路径
    - 新增 memory_store/score/extract/context/maintenance/admin/writer 及单测
    - config/pipeline/server 接入只读读取，默认 MEMORY_ENABLED=0
    - 写路径默认 MEMORY_DRY_RUN=1，异步队列处理且不落盘
    - schema 过新时只读启动告警，非法数值环境变量回退默认值
    - 未改固件、/turn 请求响应体及 X-Session-Id 可见值
2026-10-22 feat: 完成五层记忆阶段 4/5 并补齐交接文档
    - 维护接线：真实写入模式下启动评估一次，之后每个成功写盘回合累计并调用 maybe_run；dry-run/read_only 不触发
    - 退出补刷：serve 的 finally 与 run_local/record_mic 停止 writer；MEMORY_DEBUG 输出单行计数
    - 读路径优化：active_facts/active_episodes 改为只读投影，build_for_turn p50 5.7→1.3 ms
    - 缓存加界：会话 LRU 64、RecentCache 64、gen 去重 8192 FIFO
    - 新增 5 例测试；记忆 200 例、hermetic 20 模块 355 例、脚本自检 22/22
    - 补充 HANDOFF、bridge README、设计验收记录与 B/C/F/G 交接文档
    默认仍 MEMORY_ENABLED=0 + MEMORY_DRY_RUN=1；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
2026-10-22 feat: 接入本地规则命令并补齐源码与 CI 基线
    - stop/time/timer 在 pipeline 本地短路，不调 LLM，不写记忆与用量账本
    - timer 只确认时长，不承诺到点主动出声
    - 源码、固件、测试与 GitHub Actions 入库；.gitignore 排除运行时与个人音频
2026-10-22 docs: 补齐 git 基线与 test-data 忽略说明
2026-10-26 fix: 3s 播放缓冲修复长回复断续，并固件上机验证收口
    - 播放流缓冲 1s→3s（内部 RAM 不足自动降 2s/1s），长回复 underruns 从
    7.1s 回复 59 次(27%) 降到 55.7s 回复 46 次(2.6%)
    - 删除开机 6 声诊断音阶与 playDC/playSweep 死代码，三模式 0 error/0 warning
    - README 按实机事实重写供电与接线，补充上机验证结论与日志字段歧义说明
    - 新增 HANDOVER-G / NEXT-AI 交接，HANDOFF 状态同步到联网已验证
    [audio_io.cpp, audio_io.h, config.h, voice_terminal.ino]
2026-10-27 fix: 切句定案全句 ≥18 字，长回复开局不再掉音频
    真机逐句遥测证明开局缺口 ≈ 合成(第二句) − 音频(第一句)，与起播水位、播放缓冲无关；首句 ≥18、第二句 ≥20 且 26 字硬上限后，69.1 秒回复断流从 46 次降到 0 次，代价是首字节 4.4–5.2 秒。一并带上 EcoQoS 反节流（RTF 1.8→0.8）与 TTS_TRACE 逐句诊断。
    [config.h]
2026-10-27 docs: 交接单记录提交 1205609 与实际测试数
2026-10-27 feat: 接入本地应急兜底与记忆启动状态行
    云端所有 profile 都失败、且本轮还没出字时，才由 Ollama 的 2B 模型做简短回答（默认关闭，LOCAL_PLUGIN_ENABLED=1 才启用）；本地也失败则念固定句，不写账本与记忆。启动时打印 memory 开关状态，便于确认是否真实写入。测试：19 个 unittest 模块 381 例 + 三个脚本自检 29 例全过。
2026-10-27 docs: 同步三条线状态、实测数字与工作区收口
    HANDOFF/NEXT-AI/README 更新到 69.1 秒 0 次断流、首字节 4.4–5.2 秒与 26 字上限；补记本地兜底、记忆状态行、winperf 的现状，并去掉已过时的“未提交”描述。
2026-10-28 feat: 小鱼屏固件与推流链路，一并入库 10-27/10-28 未提交批次
    屏幕（本轮）：
    - 固件 display_st7789 + screen_client：横屏 320×240、SPI 40 MHz、PSRAM 帧缓冲、
    拉 GET /screen 解 JPEG 刷屏、按键上报、断线显示「电脑关机了」离线图
    - bridge screen_config/hub/compose/http：状态机（呼吸/随机插播/按键反应/
    听/想/播/错）、两行中文合成、multipart 长连接广播、POST /screen/key
    - 帧库构建：bridge/tools 用 WSL ffmpeg 转 25 段 2,449 帧（tv→pc 色阶），
    产物 20 MB 由 .gitignore 排除
    - 固件含配网 A/B（wifi_setup）与离线图 24,327 B，中文烘焙进像素、无字库
    同批未入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
2026-10-28 docs: 交接单记录屏幕已实现、字节账与未上机状态
2026-10-28 fix: worker 收尾移入 finally，异常退出也关 TTS 子进程
    tts.stop() 原先位于 main() 末尾，serve() 或建桥阶段抛异常时会跳过。
    改后正常与异常两条路径都会执行收尾；528 例 unittest 全绿。
2026-10-28 feat: 每轮成功回合写一条 event episode，补上经历层写入点
2026-10-28 docs: 旧总结合并为项目总结.md，删除被取代的 README/RUNBOOK/工程日志
2026-10-28 feat: 调试台显示今日/本月/累计花费，只读用量账本
2026-10-28 docs: 补回根 README 指路页并同步计费说明
2026-10-28 feat: 加歌页面与本地情绪标签
    - bridge/songs.py：上传/删除歌曲，仅回环地址可写，扩展名与体积校验
    - bridge/emotion.py：关键词判情绪（长词优先），首帧带动情绪标签
    - 调试台新增歌曲页，控制台显示情绪；4 个测试文件同步
2026-10-28 feat: 调试台可改人设词，上限沿用 120 字
    人设存 ~/.voice-ai/persona.txt，每轮现读，下一轮生效；空着保存恢复默认。
    POST 超限回 400 并报实际字数；接口只允许本机。页面写明五条要求与代价。
2026-10-30 feat: 调试台可换表情/动作，帧库扩到 106 段
    - 屏幕状态机加 preview 状态：show_emotion/show_auto/show_anim + 16 组 CATALOG，
    调试台新增表情卡（7 键 + 屏幕预览）和按原案分组的动作列表，带搜索框
    - 本机接口 POST /api/screen/emotion、/api/screen/anim，GET /api/screen/catalog、
    /api/screen/frame；build_screen 改成 hub 常驻，只有 SCREEN_ENABLED=1 才推流
    - 帧库 25 段 / 2,449 帧 → 106 段 / 10,549 帧（帧产物不进仓库）
    - 同批带上调试台的大字模式与对话/一句话重播（/api/history、/api/replay），
    以及 bridge 启停脚本 check-memory.ps1 / shutdown-bridge.ps1
2026-10-30 feat: 离线语音唤醒「你好小鱼」，10-29 上机验证
    不用 WakeNet（官方只有 Hi ESP 模型，改不了词），改用 MultiNet 中文命令
    识别（mn7_cn）把「你好小鱼」注册成唯一命令词，命中即唤醒，之后走与
    BOOT 键完全相同的 录音→上传→播放 流程。
    - 新增 wake_word.{h,cpp}（AFE+MultiNet 驱动）、esp_mn_commands_cn.c
    （草图内同名 .c 覆盖静态库里的英文 g2p 分支，中文命令不再被拒，顺带
    不再链接 flite，APP 从 3,195,507 降到 2,574,083 B）、partitions.csv
    （custom：5MB APP / 6.9MB SPIFFS / 4MB MODEL@0xBF0000，无 BOM 无注释）。
    - voice_terminal.ino：IDLE 常开监听，录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
    [partitions.csv]
2026-10-30 fix: 一键启动不再起 Ollama，并区分"正在加载"与"没带记忆"
    - 本地千问模型 10-30 已全删，启动器不再拉起 ollama serve（恢复办法写在注释里）。
    - 双击第二次时模型正在加载：SO_REUSEADDR 会让两个进程都绑上 8080，于是
    改成先数 python 进程，有就跑等待循环，不重复加载。
    - 已在跑但没带记忆的 bridge（不是用 start-bridge.cmd 起的）会让页面看着像
    "快捷方式没反应"：先问 check-memory.ps1，返回 0 就关机重启一次。
